ostojaatanasijevic/3d_print_sonda_koncept/documentation/3d_print_sonda_koncept.pdf

## DS100M06VL

19. oktobar 2025.

## Sadrˇzaj

1 Mounting holes | 3
2 Input connectors | 3
3 Charging connector | 3
4 Input divider | 4
5 Offset results | 5
6 Sources of offset | 5
7 Output diff amp | 6
8 Noise | 6
9 Issues | 6
10 Asymetric gain | 6

## 1 Mounting holes

4 mounting posts are spaced in a 80 mm by 40 mm rectangle. Plastic post hole width is about 2.5 mm, but to allow for a self tapping screw, the PCB hole must be M3.

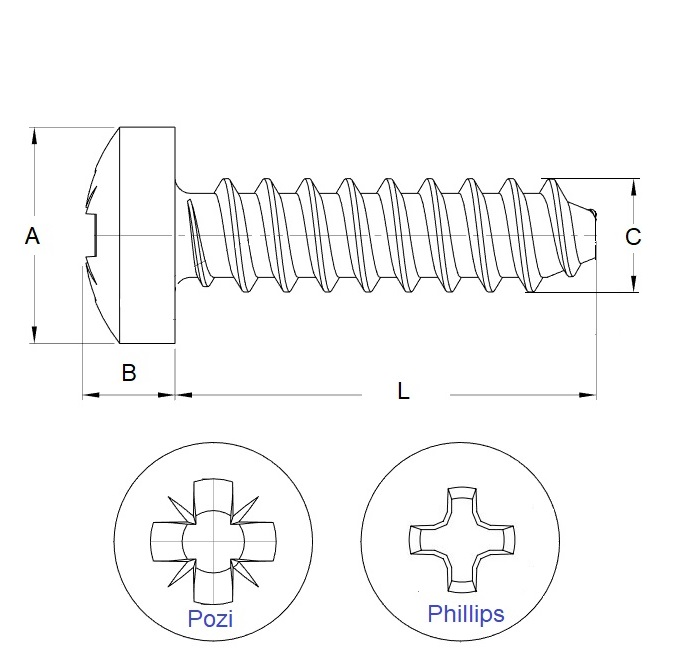
[picture p1: figure]

Apropriate screw is has a B of 2 mm, L of 6 mm, A of 5 mm and C of 3 mm.

## 2 Input connectors

2.1 PCB mount connector

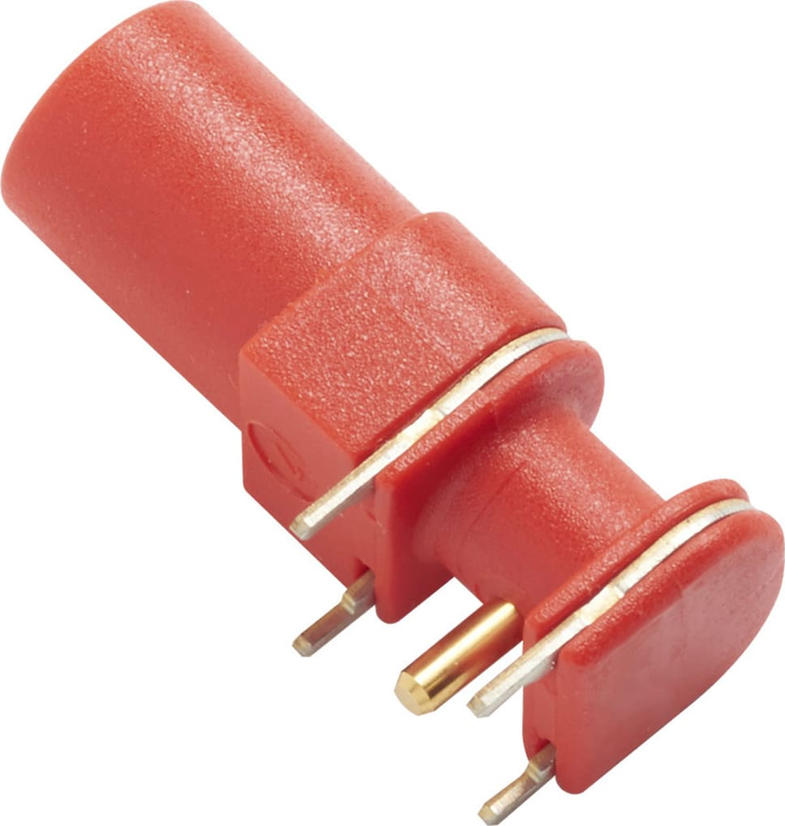
[picture p2: figure]

Pomona connector (https://www.mouser.co.uk/ProductDetail/Pomona-Electronics/73099-2?qs=B6kkDfuK7%2FA6DpEPKtHqWw%3D%3D) cost around 8 EUR.

2.2 Panel mount

## 3 Charging connector

3.1 Panel mount USB C

Aliexpress panel mount USB C connector (https://www.aliexpress.com/item/1005005795420370.html?scm_id=1007.40000.327270.0&scm-url=1007.40000.327270.0) cost around 1.2 EUR per 10 qty.

This connector may not have the required resistors in order to negociate current demand Kupujemprodajem konektor (https://www.kupujemprodajem.com/elektronika-i-komponente/moduli-za-samoizgradnju/usb-c-konektor-za-montazu/oglas/149804414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)

## 4 Input divider

4.1 Resistance divider

With single sided input impedance of 4 Meg and a required attenuation of 1:400, total impedance from opamp input to gnd must be:

Rin =

4 MΩ
399
= 10.025 kΩ | (1)

Total resistance to ground is a parallel connection of the dividing resistor, 10 MΩ input offset trim pot and 10 MΩ opamp input resistance.
Dividing resistor value should then equal:

Rdiv =

5MΩ · 10.025kΩ
5MΩ − 10.025kΩ = 10.045Ω | (2)

Placing a 0.1% resistor (10.010 kΩ max), trim pot should be around 50 Ω.

4.2 Capacitance divider

4 series 10 pF capacitors yield total 2.5 pF with a tolerance of 5%. In order to achieve 1:400 attenuation, total capacitance on the buffers input pin should be 997.5 pF. If we account for the 5% tolerance, total capacitance should be trimmable in the range for 947.62 pF to 1047.4 pF. AD8039 (https://www.analog.com/media/en/technical-documentation/data-sheets/AD8038_8039.pdf) features a typical input capacitance of 2 pF and thus should not significantly impact the total capacitance.

4.2.1 Trim potenciometers

Available trimmable capacitor has a capacitance range from 8 pF to 50 pF, not enough to account for the 5% capacitor tolerance.
These trim capacitors are expensive (5 EUR per 1 qty) and are only single turn, limiting trim accuracy.

4.2.2 Varicap trimming

In order to allow for auto-calibration, input capacitance needs to be control voltage dependant. To achieve this, a varicap diode may be used.
This component can be trimmed manually, using a trim potentiometer.
Since varicap add a voltage dependant capacitance value, total capacitance before the adding the varicap needs to be less then the total capacitance required.
As 5% capacitors are used, fixed capacitors used should equal:

Cplaced =

Creq
1.05
− Cvaricap min | (3)

Parallel connection of 2 470 pF yield capacitance in the range of 893 pF to 987 pF.
Since the capacitance change required is 10% of required capacitance, varicap capacitance change in the available control voltage range (0 V to 5V) must be around 100 pF.

Diode selection:

- Cheaper varicap diode is toshibas (https://eu.mouser.com/ProductDetail/Toshiba/1SV324TPH3F?qs=EEns8I54Y6DPMP6VMy8m2w%3D%3D) at 0.26 EUR per 10 qty.

- Better documented varicap diode is skyworks (https://eu.mouser.com/ProductDetail/Skyworks-Solutions-Inc/SMV1255-079LF?qs=WMHGlxXAKT8jslp0hTOZuw%3D%3D) at 0.51 EUR per 10 qty.

PCB needs to support both of these diode footprints.

## 5 Offset results

5.1 10x gain enabled

-8.5 mV

5.2 1x gain enabled

9.2 mV

5.3 solving

Vof f 10 = 10 · (2Vin of f + Vcurr of f ) + Vout of f | (4)
Vof f 1 = 2Vin of f + Vcurr of f + Vout of f | (5)
Vof f 10 − Vof f 1 = 9 · (2Vin of f + Vcurr of f ) = −17.7mV | (6)

Total input offset is -2 mV. Total output offset is 11.2 mV.

## 6 Sources of offset

6.1 Input buffer

6.1.1 Input bias current offset

AD8039 has an input bias current offset of 25nA, across the 20 kΩ input impedance, generates 0.5 mV of offset. Taking into account the second input buffer, maximum offset is 1 mV.

6.1.2 Input voltage offset

AD8039 has an max input voltage offset of 3mV. Worst case total offset is 6mV.

6.2 Output buffer

6.2.1 Input bias current offset

AD8009 has an max input current offset of 150µA. With an input impedance of 100 Ω, total offset is 15 mV. If both inputs have opposing offsets, the total offset is 30 mV

6.2.2 Input voltage offset

AD8009 has an max input voltage offset of 5mV.

## 7 Output diff amp

AD8039 load resistor is it’s outputs series resistor.

## 8 Noise

8.1 Resistor noise

Vrms =

p
4kBT R∆f | (7)

At the bandwidth of 100 MHz and temperature of 25 ◦C, noise is

Vrms = 3.63mVRMS | (8)

8.2 Input buffer noise

AD8039 has an input noise level of 8nV/

√
Hz meaning that total input noise rms at 100 MHz bandwidth is 80 µVRMS.

8.3 Output buffer noise

AD8009 has an input noise level of 1.9nV/

√
Hz meaning that total input noise rms at 100 MHz bandwidth is 19 µVRMS.

## 9 Issues

## 10 Asymetric gain

At 100 mode, positive input connected to sig gen at 30 Mhz, reades 6.7 Vpp instead of 10 Vpp. In this configuration, AD8039 buffers sees 1 kOhm resistor from output to AD8009 input and 2 kOhm after that to ground.
Moving to 100 and 200 combo improves response, now closer to 8 Vpp
