ostojaatanasijevic/3d_print_sonda_koncept/simulacije/lin.asc

D1: diode; 1N4148
D2: diode; 1N4148
D3: diode; 1N4148
I1: current; 2m
Q1: npn; 2N5551
Q2: npn; 2N5551
Q3: npn; 2N5551
Q4: pnp; 2N5401
R1: res; 1k
R3: res; 10k
R5: res; 1k
R6: res; 2k
R7: res; 3
R8: res; 1k
R9: res; 1k
V2: voltage; PULSE({Vbat - ripple } {Vbat + ripple } 0 0 0 20u 40u)
Named nets: 0, bat
.tran 0 1m 100u
.ic V(bat) = 0
.step param Vbat list 3.9 4.2 5 6 7
.param ripple = 0
