ostojaatanasijevic/3d_print_sonda_koncept/simulacije/two_opamp/redirect_ratio_analysis_ac.asc

C1: cap; 10p
C2: cap; 10p
C3: cap; 10p
C4: cap; 10p
C5: cap; 10p
C6: cap; 10p
C7: cap; 10p
C8: cap; 10p
C9: cap; 975p
C10: cap; 110p
C11: cap; 990p
C12: cap; 10p
C13: cap; 10p
C14: cap; 10p
C15: cap; 10p
C16: cap; 10p
C17: cap; 10p
C18: cap; 10p
C19: cap; 108.33p
C20: cap; 10p
C23: cap; 47p
C24: cap; 47p
C25: cap; 10p
C26: cap; 10p
C27: cap; 10p
C28: cap; 10p
C29: cap; 10p
C30: cap; 10p
C31: cap; 10p
C32: cap; 10p
C33: cap; 55.5p
C34: cap; 55.5p
C35: cap; 470p
C36: cap; 470p
C37: cap; 10p
C38: cap; 10p
C39: cap; 10p
C40: cap; 10p
C41: cap; 10p
C42: cap; 10p
C43: cap; 10p
C44: cap; 10p
C45: cap; 55.5p
C46: cap; 55.5p
C47: cap; 470p
C48: cap; 470p
C49: cap; 470p
C50: cap; 470p
C51: cap; {par_cap}
C52: cap; {par_cap}
C53: cap; {par_cap}
C54: cap; {par_cap}
C55: cap; 470p
C56: cap; 470p
C57: cap; 47p
C58: cap; 47p
C59: cap; {par_cap}
C60: cap; {par_cap}
C61: cap; {par_cap}
C62: cap; {par_cap}
L1: ind; 15n
L2: ind; 15n
L3: ind; 15n
L4: ind; 15n
L7: ind; 15n
L8: ind; 15n
L9: ind; 15n
L10: ind; 15n
L11: ind; 15n
L12: ind; 15n
R1: res; 10k
R2: res; 10k
R3: res; 256
R4: res; 256
R5: res; 1Meg
R6: res; 1Meg
R7: res; 1Meg
R8: res; 1Meg
R9: res; 1Meg
R10: res; 1Meg
R11: res; 1Meg
R12: res; 1Meg
R13: res; 1Meg
R14: res; 1Meg
R15: res; 1Meg
R16: res; 1Meg
R17: res; 102k
R18: res; 102k
R19: res; 560
R20: res; 560
R21: res; 100k
R22: res; 92.308k
R23: res; 1200k
R24: res; 1Meg
R25: res; 1Meg
R26: res; 1Meg
R27: res; 1Meg
R28: res; 1Meg
R29: res; 1Meg
R30: res; 1Meg
R31: res; 1Meg
R32: res; 100
R33: res; 100
R39: res; 10k
R40: res; 10k
R41: res; 10k
R42: res; 10k
R43: res; 25
R44: res; 25
R45: res; 1Meg
R46: res; 1Meg
R47: res; 1Meg
R48: res; 1Meg
R49: res; 1Meg
R50: res; 1Meg
R51: res; 1Meg
R52: res; 1Meg
R53: res; 100
R54: res; 100
R55: res; 100
R56: res; 100
R57: res; 500
R58: res; 500
R59: res; 500
R60: res; 500
R61: res; 25
R62: res; 25
R63: res; 1Meg
R64: res; 1Meg
R65: res; 1Meg
R66: res; 1Meg
R67: res; 1Meg
R68: res; 1Meg
R69: res; 1Meg
R70: res; 1Meg
R73: res; 100
R74: res; 100
U1: opamp2; TLV354
U2: opamp2; TLV354
V1: voltage; 2.75
V2: voltage; -2.75
V3: voltage; 0; AC 1
V4: voltage; 9
V5: voltage; 0; AC 1
V6: voltage; -9
V7: voltage; {five}
V8: voltage; {five}
V9: voltage; 30
V10: voltage; 0; AC 1
V11: voltage; 0; AC 1
V12: voltage; 0; AC 1
V13: voltage; 0; AC 1
V14: voltage; 500
Named nets: 0, 2.5V, -2.5V, 9V, -9V, 5V, -5V
;tran 1m
.param five=5
.param par_cap = 1p
1 / 400
82.5 dB CMRR at 100 kHz
.ac dec 100 100 100Meg
.lib TLV354.LIB
1 / 400
82.5 dB CMRR at 100 kHz
;ac dec 100 100 1000Meg
.lib TLV354.LIB
1 / 400
82.5 dB CMRR at 100 kHz
;ac dec 100 100 100Meg
1 / 400
82.5 dB CMRR at 100 kHz
;ac dec 100 100 100Meg
