ostojaatanasijevic/3d_print_sonda_koncept/simulacije/charge_pump/complete_linear_regulator.asc

C1: cap; 47µ
C2: cap; 47µ
C3: cap; 47µ
C4: cap; 47µ
C5: cap; 47µ
C6: cap; 47µ
C7: cap; 1µ
C8: cap; 47µ
C9: cap; 1µ
C10: cap; 1µ
C11: cap; 1µ
C12: cap; 1µ
C13: cap; 47µ
C14: cap; 1µ
C15: cap; 1µ
C16: cap; 47µ
C18: cap; 1µ
D1: diode; 1N4148
D2: diode; 1N4148
D3: diode; 1N4148
D4: diode; 1N4148
D5: diode; 1N4148
D6: diode; 1N4148
D7: diode; 1N4148
D8: diode; 1N4148
I1: current; 7m
I2: current; 7m
I3: current; 7m
I4: current; 1m
I5: current; 7m
I6: current; 7m
I7: current; 7m
I8: current; 7m
I9: current; 7m
Q1: npn; 2N5551
Q2: pnp; 2N5401
Q3: npn; 2N5551
Q4: pnp; 2N5401
Q5: npn; 2N5551
Q6: pnp; 2N5401
Q7: npn; 2N5551
Q8: pnp; 2N5401
Q9: npn; 2N5551
Q10: npn; 2N5551
Q11: npn; 2N5551
Q12: npn; 2N5551
Q13: npn; 2N5551
Q14: npn; 2N5551
Q15: npn; 2N5551
Q16: npn; 2N5551
Q17: pnp; 2N5401
Q18: pnp; 2N5401
Q21: npn; 2N5551
Q22: npn; 2N5551
Q23: npn; 2N5551
Q24: pnp; 2N5401
Q25: pnp; 2N5401
Q26: npn; 2N5551
Q27: npn; 2N5551
Q28: npn; 2N5551
Q29: pnp; 2N5401
Q30: pnp; 2N5401
Q31: npn; 2N5551
Q32: npn; 2N5551
Q33: pnp; 2N5401
Q34: pnp; 2N5401
Q35: pnp; 2N5401
Q36: pnp; 2N5401
Q37: pnp; 2N5401
R1: res; 68k
R2: res; 1k
R3: res; 1Meg
R4: res; 1k
R5: res; 1Meg
R6: res; 6.8k
R7: res; 1k
R8: res; 1k
R9: res; 1m
R10: res; 1m
R11: res; 100k
R12: res; 100k
R13: res; 22k
R14: res; 22k
R15: res; 10k
R16: res; 2.2k
R17: res; 10k
R18: res; 2.2k
R19: res; 22k
R20: res; 78k
R21: res; 68k
R22: res; 10k
R23: res; 78k
R24: res; 68k
R25: res; 10k
R26: res; 10k
R27: res; 2.5k
R28: res; 10k
R29: res; 100k
R30: res; 510
R33: res; 6.8k
R34: res; 2.5k
R35: res; 600
R36: res; 10k
R37: res; 10k
R38: res; 6k
R39: res; 1k
R40: res; 3k
R41: res; 6.8k
R42: res; 2.5k
R43: res; 10k
R44: res; 6k
R45: res; 100k
R46: res; 10k
V1: voltage; PULSE({Vbat - ripple } {Vbat + ripple } 0 0 0 20u 40u)
V5: voltage; PULSE({Vbat - ripple } {Vbat + ripple } 0 0 0 20u 40u)
Named nets: vout+, vout-, pos, neg, 0
.tran 10m
.step param Vbat list 3.4 3.6 3.8 4 4.2 4.5 5.6 7 8
.param ripple = 100m
