ostojaatanasijevic/3d_print_sonda_koncept/simulacije/charger/discrete_charger.asc

C1: cap; 1000µ
D1: diode; 1N4148
D2: diode; 1N4148
Q1: npn; 2N5551
Q2: npn; 2N5551
Q3: npn; 2N5551
Q4: pnp; 2N5401
Q5: npn; 2N5551
Q6: npn; 2N5551
R1: res; 1k
R2: res; 100k
R3: res; 1Meg
R4: res; 1k
R5: res; 1k
R6: res; 820k
R7: res; 3
V1: voltage; 5.5
Named nets: 0, bat
.tran 1
.ic V(bat) = 0
