ostojaatanasijevic/3d_print_sonda_koncept/simulacije/charger/discrete_charger_TL431.asc

C1: cap; 1000µ
C2: cap; 1000µ
C3: cap; 10000µ
C4: cap; 1000µ
C5: cap; 100n
D1: schottky; 1N5819
D2: schottky; 1N5819
D3: schottky; 1N5819
M1: pmos; AO4630_P
M2: pmos; AO4630_P
Q1: npn; 2N5551
Q2: npn; 2N5551
Q3: npn; 2N5551
Q4: npn; 2N5551
Q5: npn; 2N5551
Q6: npn; 2N5551
Q7: npn; 2N5551
Q8: pnp; 2N5401
Q9: npn; 2N5551
Q10: npn; 2N5551
Q11: npn; 2N5551
Q12: npn; 2N5551
R1: res; 820k
R2: res; 510k
R3: res; 1Meg
R4: res; 3
R5: res; 510k
R6: res; 330k
R7: res; 3
R8: res; 100
R9: res; 100k
R10: res; 100
R11: res; 82k
R12: res; 51k
R13: res; 3
R15: res; 51k
R16: res; 100
R17: res; 100k
R19: res; 82k
R20: res; 51k
R21: res; 3
R22: res; 100
R23: res; 100k
R24: res; 100k
R25: res; 51k
R26: res; 1k
R27: res; 100k
U1: TL431
U2: TL431
U3: TL431
U4: TL431
V1: voltage; PULSE(0 5.5 0 1u 1u 300m 600m)
Named nets: 0, bat, vin, bat2, bat3
.tran 1
.ic V(bat2) = 2.2
.ic V(bat) = 2.2
.ic V(bat3) = 2.2
30 uA loss when not charging
24 uA loss when not charging
5 uA max loss when not charging
