ostojaatanasijevic/3d_print_sonda_koncept/simulacije/charge_pump/logicoscilator.asc

C1: cap; 100p
C2: cap; 100n
D1: diode; 1N4148
E1: e; 1
R1: res; 100k
R2: res; 1Meg
R6: res; 33k
U2: SN74HC14
V5: voltage; 3.6
Named nets: 0, out
.param fsw = 40k
.param d = 0.5
.param Cf = 10u
.tran 0 50u 0 500p uic
.ic V(out) = 3.6
