ostojaatanasijevic/3d_print_sonda_koncept/(commit log)

2025-12-14 Some errors fixed.
    [DS100M08KV2.kicad_pcb, DS100M08KV2.kicad_sch, power_supply.kicad_sch]
2026-05-31 right angle 4 mm
    [DS20M05V.kicad_pcb, DS20M05V.kicad_sch]
